leoxxx00/Solid-work-Lamp-design/Final/anglepoise bulk costs for a single lamp (1).xlsx

Sheet: Sheet1
Name | Decription | Source Reference | QTY | BULK COST | Quantity used for a single lamp | Materials Cost for a single lamp
Materials for manufactured parts
Vacuum form plastic | 1.5 mm hips white plastic sheet 1220x915 | https://shop.stephen-webster.co.uk/product/high-impact-polystyrene-hips-gloss-matt-sheet/ | 1 | £14.46 | 20% | £2.08
alluminium | 10x10 channel 2m | https://www.aluminiumwarehouse.co.uk/10-mm-x-10-mm-x-2-mm-x-2-mm-aluminium-channel | 1 | £3.49 | 30% | £1.20
Postcrete | 20kg bag for base | https://www.wickes.co.uk/Blue-Circle-Ready-To-Use-Postcrete---20kg/p/221100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 | 1 | £4.75 | 1.50% | £0.12
Ultimaker build material | PLA filament 750g | https://3dgbire.com/collections/filaments/products/ultimaker-pla-white-filament?variant=27701729089 | 1 | £39.00 | 25% | £4.68
Stratysys Build material | ABS filament 983 cm3 | https://store.stratasys.com/stratasysstorefront/stratasys/en/Materials-%26-Service-Consumables/NA/Flavors/333-60302/p/333-60302 | 1 | £117.00 | 12% | £5.73
stainless steel rod | 5mm x 2m | https://www.metals4u.co.uk/materials/stainless-steel/stainless-steel-round/1674-p | 1 | £6.75 | 10% | £0.68
stainless steel rod | 3mm x 2m | https://www.metals4u.co.uk/materials/stainless-steel/stainless-steel-round/1659-p | 1 | £5.25 | 4.00% | £0.22
zinc plated threaded rod | M4 threaded rod 1m for base unit | https://www.orbitalfasteners.co.uk/products/m4-x-1m-mild-steel-studding-threaded-rod-grade-4-6-bright-zinc-plated-din-975 | 1 | £0.45 | 2.60% | £0.12
stainless threaded rod | M5 threaded rod 1m for connector | https://www.orbitalfasteners.co.uk/products/m5-x-1m-stainless-steel-studding-threaded-rod-a4-316-din-975 | 1 | £1.93 | 1.70% | £0.33
oak | 2mx620x40 wooden worktop for base unit | https://www.worktop-express.co.uk/wood_worktops/oak_worktops.html | 1 | £135.00 | 0.70% | £0.94
Plywood | 4mm Poplar Laser Plywood, 600mm x 300mm AB/AB | https://kitronik.co.uk/collections/plywood/products/3267-4mm-poplar-laser-plywood-600mm-x-300mm-abab | 1 | £2.82 | 20% | £0.56
Standard Parts
pins 30mm | 1 bag of 30 pins for spring support | https://www.amazon.co.uk/gp/product/B07G11FRXH/ref=ppx_yo_dt_b_asin_title_o01_s00?ie=UTF8&psc=1 | 30 | £7.99 | 4 Pins | £1.00
Elastic bands | 1kg bag 38x1.7 | https://www.amazon.co.uk/gp/product/B01N060OHF/ref=ppx_yo_dt_b_asin_title_o08_s00?ie=UTF8&psc=1 | 1 | £12.90 | 20 bands | £0.09
M5 threaded inserts | 50 M5x9.5 for plastic connector and wood base unit | https://www.amazon.co.uk/gp/product/B07YSVXWS8/ref=ppx_yo_dt_b_asin_title_o01_s01?ie=UTF8&psc=1 | 50 | £11.15 | 4 (QTY) | £1.84
M8 Threaded insert | 15 M8 threaded inserts for wooden base unit | https://www.amazon.co.uk/gp/product/B074J82JF7/ref=ppx_yo_dt_b_asin_title_o01_s00?ie=UTF8&psc=1 | 15 | £8.99 | 1 (QTY) | £0.60
knurled thumb screws | 10 Thumb screws for connector tightening | https://www.amazon.co.uk/gp/product/B07LFRB5VZ/ref=ppx_yo_dt_b_asin_title_o00_s00?ie=UTF8&psc=1 | 10 | £5.49 | 2 (QTY) | £1.10
nylon washers | M5 10mm 1mm thick | https://www.orbitalfasteners.co.uk/products/m5-nylon-66-washers-white-din-125-1a | 100 | £1.35 | 40 (QTY) | £0.03
M8 Allen bolt | 20 M8 allen bolt base attachment | https://www.amazon.co.uk/gp/product/B079611XWN/ref=ppx_yo_dt_b_asin_title_o00_s00?ie=UTF8&psc=1 | 20 | £6.89 | 3 (QTY) | £1.03
M8 Washer | M8 washer for base attachment | https://www.screwfix.com/p/easyfix-a2-stainless-steel-flat-washers-m8-x-1-6mm-100-pack/8339t | 100 | £2.79 | 1 (QTY) | £0.28
M5 Washer | M5 washer | https://www.accu.co.uk/flat-washers/465683-HPW-4-3-9-0-8-N?uk_google_shopping=1&c=3 (https://www.amazon.co.uk/10mm-Allen-Socket-Head-Screws/dp/B08GY8PCTN) | 50 | £4.45 | 2 | £17.80
M5 allen bolt | M5 22mm allen bolt | https://www.screwfix.com/p/easyfix-button-head-socket-screws-a2-stainless-steel-m5-x-16mm-50-pack/8345t | 50 | £3.09 | 4 (QTY) | £0.25
M3 allen bolt | M3 (3mm x 10mm) Allen Socket Cap Head Screws | https://www.amazon.co.uk/10mm-Allen-Socket-Head-Screws/dp/B08GY8PCTN | 20 | £4.99 | 2 | £0.50
lamp holder | Baynonet fixing lamp holder | https://www.electricalcounter.co.uk/products/Wiring+Accessories/Ceiling+Accessories/T2+BC+Cord+Grip+Lampholder+IP20+100W+230V/1937848833 | 1 | £0.84 | 1 (QTY) | £0.84
cable | 50m 2 core cable | https://www.screwfix.com/p/time-2192y-white-2-core-0-75mm-flexible-cable-50m-drum/49458 | 1 | £9.99 | 2.70% | £0.27
Plug | 3 pin plug | https://www.screwfix.com/p/diall-13a-fused-plug-white/5751h | 10 | £7.90 | 1 (QTY) | £0.86
fuse | 3amp fuse pack of 10 | https://www.amazon.co.uk/gp/product/B07FVT444P/ref=ppx_yo_dt_b_asin_title_o00_s00?ie=UTF8&psc=1 | 10 | £1.90 | 1 (QTY) | £0.19
M8 screw head | M8-1.25 Hex Nuts, Stainless Steel 304(A2) Hex Nut, Bright Finish | https://www.amazon.co.uk/M8-1-25-Stainless-Bright-Finish-Quantity/dp/B094Z6VZ9X?sp_csd=d2lkZ2V0TmFtZT1zcF9hdGY | 20 | £6.49 | 2 (QTY) | £0.65
Consumables
super glue | 50g - for 25mm pin attachment | https://www.screwfix.com/p/no-nonsense-superglue-50g/79181 | 1 | £1.99 | 10G | £0.40
thread lock | 50ml - for allen bolts in threaded inserts | https://www.amazon.co.uk/gp/product/B01IEIZCX4/ref=ppx_yo_dt_b_asin_title_o00_s00?ie=UTF8&psc=1 | 1 | £8.50 | 5ml | £0.85
PVA glue | 5 litres PVA for sealing concrete | https://www.screwfix.com/p/no-nonsense-pva-5ltr/57248 | 1 | £9.99 | 10ml | £0.20
Alumium soldering rod | DURAFIX® - 20 Aluminum Welding rods | https://www.amazon.co.uk/gp/product/B00RD9CFX6/ref=ox_sc_saved_title_2?smid=AN4YM79HKEWTY&psc=1 | 1 | £34.37 | 4g | £0.60
 |  |  |  | £482.95 |  | £46.04
Cost of Assembly
One person | A person with one hour per 15 pounds rate |  |  |  |  | £15.00
 | (Estimated assembly time is one lamp per an hour) |  |  |  | Total cost per Lamp | £61.04

Sheet: Sheet2
electronics advanced
PCB + LED |  | https://www.kitronik.co.uk/2169-round-5v-led-matrix-lamp.html | 1 | £2.34
in-line switch | what core cable what amp req | https://www.amazon.co.uk/in-LINE-Switch-2A-White/dp/B007K7TA66 | 1 | £1.75
stand off mounts |  | https://www.ukpos.com/acrylic-sign-standoffs-hole-mount?vat=2 | 2 | £2.00
