leoxxx00/Solid-work-Lamp-design/ASSEMBLY/Assembly instructions steps solid files/step 13.SLDASM

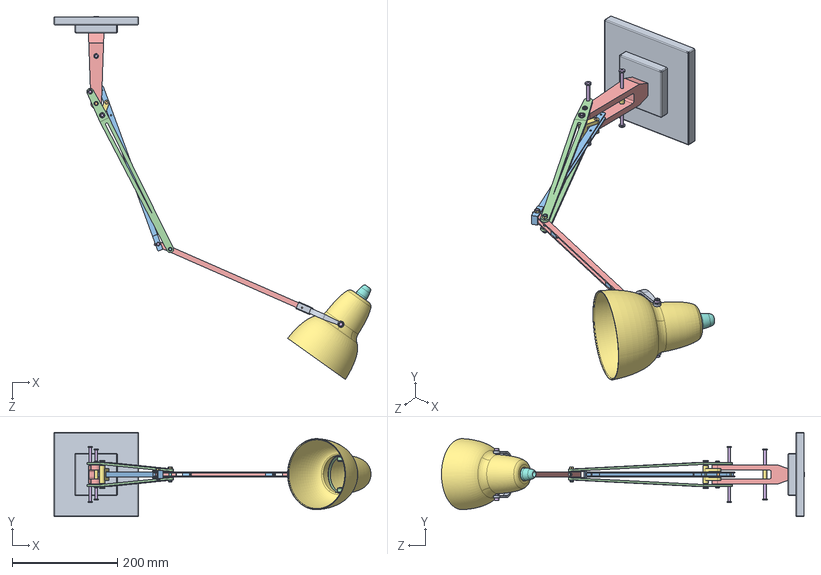
[picture p3: CAD file, 2024-01-07]
ASSEMBLY/Assembly instructions steps solid files/step 13.SLDASM
601.1 x 160.0 x 688.3 mm
Angle pose base plane 1
M8 base screw 2
M8 base washer 3
base threaded insearts 4
lamp base 5
biding pin 6 x 4
tube (M3 threaded bar holder) 8
M3 threded bar 7
threaded insert for lamp nase uppper screws 9 x 2
m5 14.5mm screw x 2
washer for upper screws of lamp base 10 x 2
outer wodden arms 11 x 2
screw 3mm into biding pin of outer arms 12 x 2
threaded bar M5 54mm 13
Angle poise connector 15
washer for M5 threaded bar 16 x 2
Thumb screw M5 17 x 2
threaded bar M5 22mm 14
1st tyer inner metal arm 18
3mm x 10 mm rod 19 x 2
2nd tyer inner arm 20
M8 Allen bolt short 22
M8 Allen bolt head 23 x 2
M8 Allen bolt long 21
Angle poise Yoke 25
3mm yoke refill cylinder rod 24
wire holder 31 x 4
Angle poise lampshade Reinforcement 28
reinforcement m5 threaded insearts 29 x 2
York M5 screw 26 x 2
Anglepoise lamphead 27
light fitting 30
