leoxxx00/Solid-work-Lamp-design/ASSEMBLY/Assembly instructions steps solid files/step 2.SLDASM

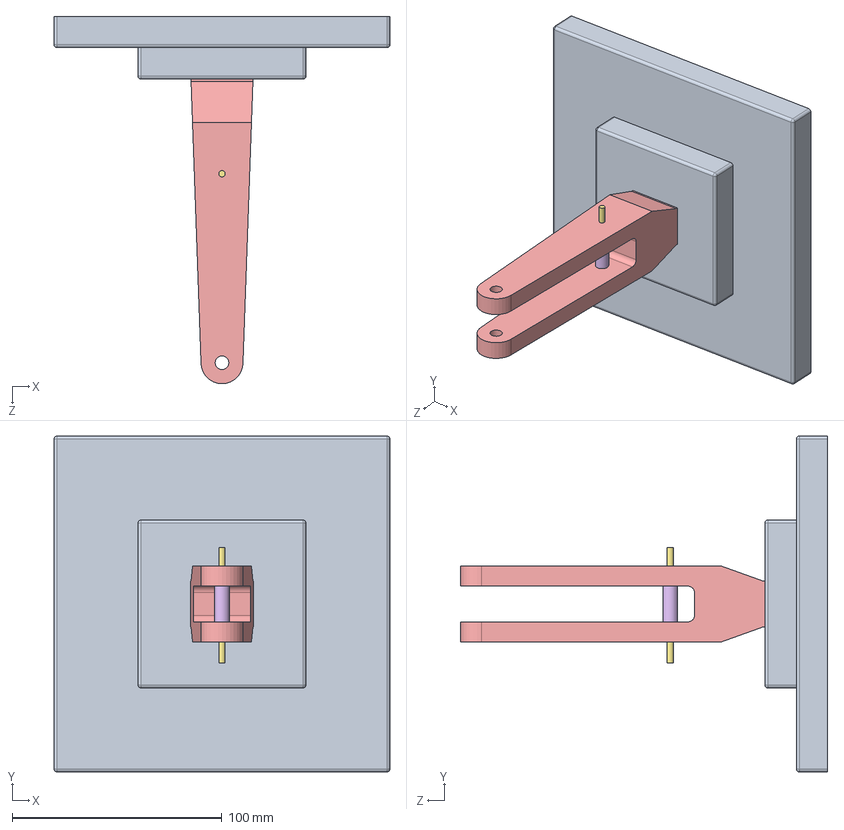
[picture p4: CAD file, 2024-01-07]
ASSEMBLY/Assembly instructions steps solid files/step 2.SLDASM
160.0 x 160.0 x 175.0 mm
Angle pose base plane 1
M8 base screw 2
M8 base washer 3
base threaded insearts 4
lamp base 5
tube (M3 threaded bar holder) 8
M3 threded bar 7
