leoxxx00/Solid-work-Lamp-design/ASSEMBLY/Assembly instructions steps solid files/step 1.SLDASM

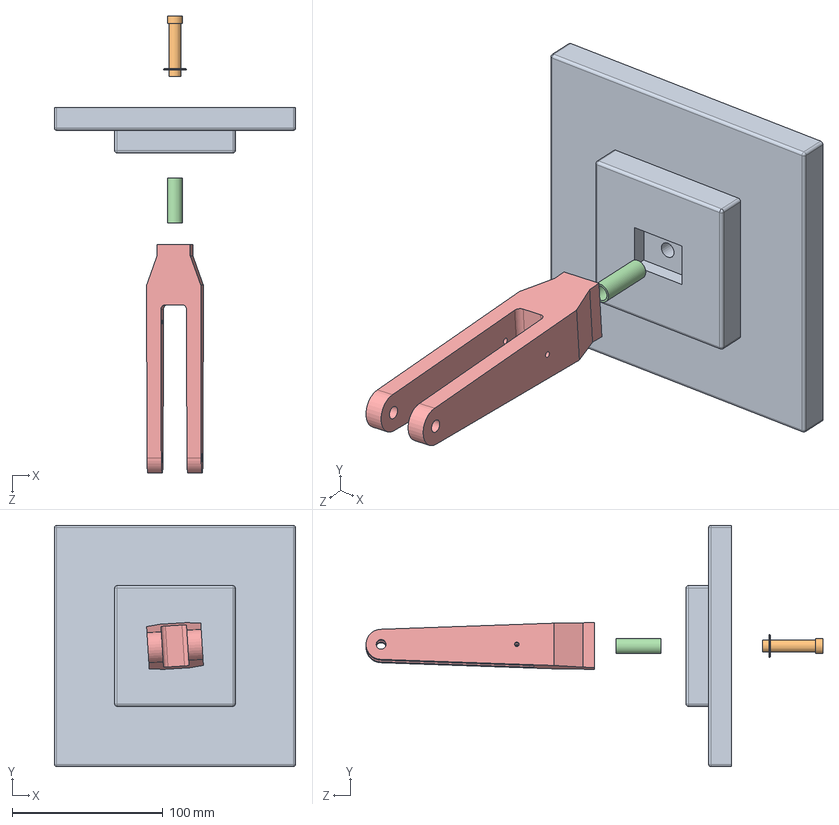
[picture p5: CAD file, 2024-01-07]
ASSEMBLY/Assembly instructions steps solid files/step 1.SLDASM
160.0 x 160.0 x 302.9 mm
Angle pose base plane 1
M8 base screw 2
M8 base washer 3
base threaded insearts 4
lamp base 5
