leoxxx00/Solid-work-Lamp-design/ASSEMBLY/Assembly instructions steps solid files/step 4.SLDASM

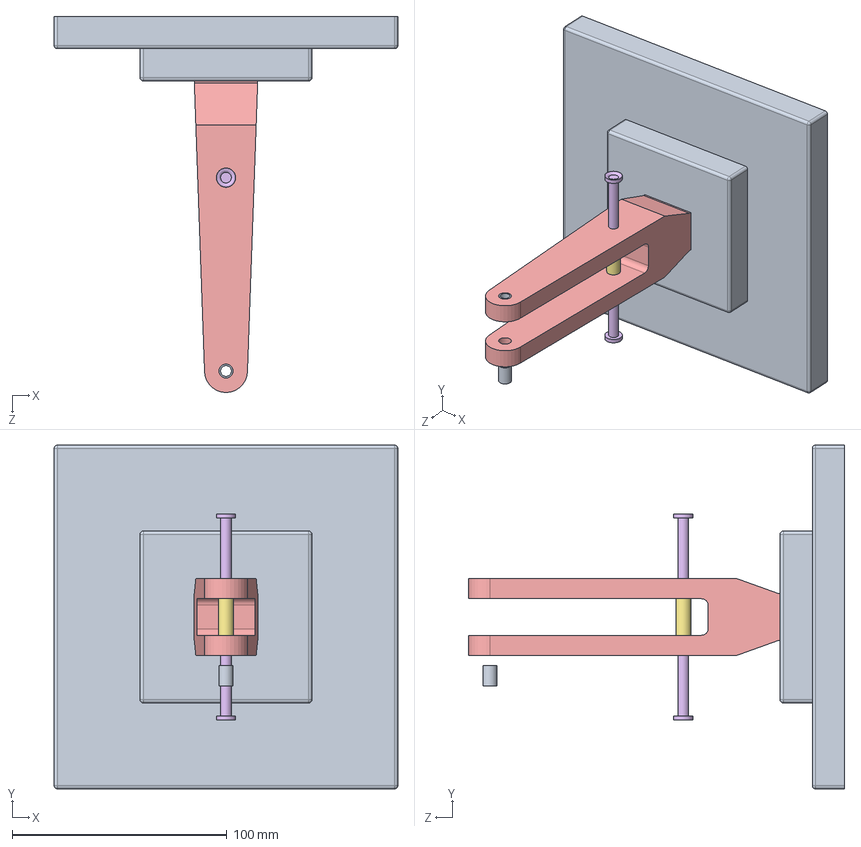
[picture p9: CAD file, 2024-01-07]
ASSEMBLY/Assembly instructions steps solid files/step 4.SLDASM
160.0 x 160.0 x 175.0 mm
Angle pose base plane 1
M8 base screw 2
M8 base washer 3
base threaded insearts 4
lamp base 5
biding pin 6 x 2
tube (M3 threaded bar holder) 8
M3 threded bar 7
threaded insert for lamp nase uppper screws 9 x 2
