leoxxx00/Solid-work-Lamp-design/PARTS/tube (M3 threaded bar holder) 8.SLDPRT

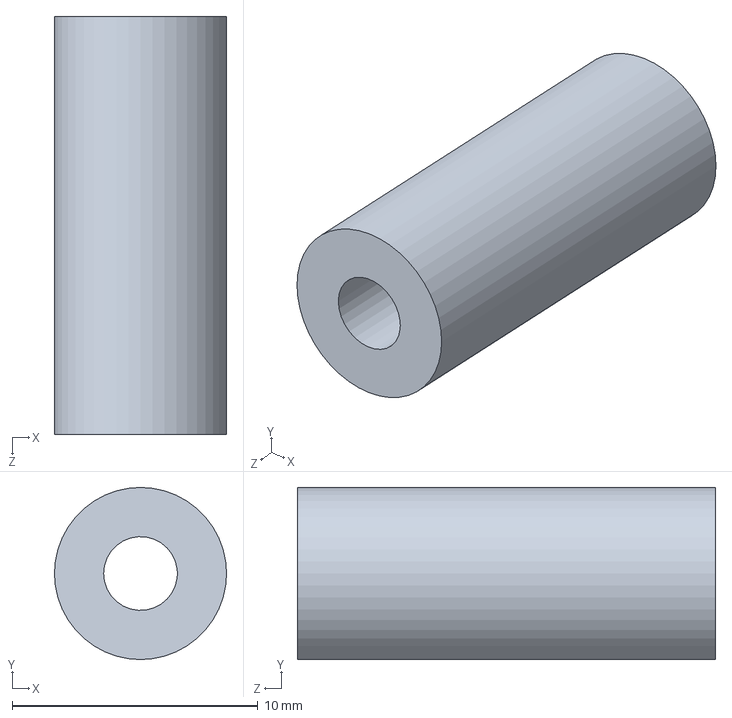
[picture p18: CAD file, 2024-01-07]
PARTS/tube (M3 threaded bar holder) 8.SLDPRT
7.00 x 7.00 x 17.0 mm
