leoxxx00/Solid-work-Lamp-design/PARTS/Angle poise lampshade Reinforcement 28.SLDPRT

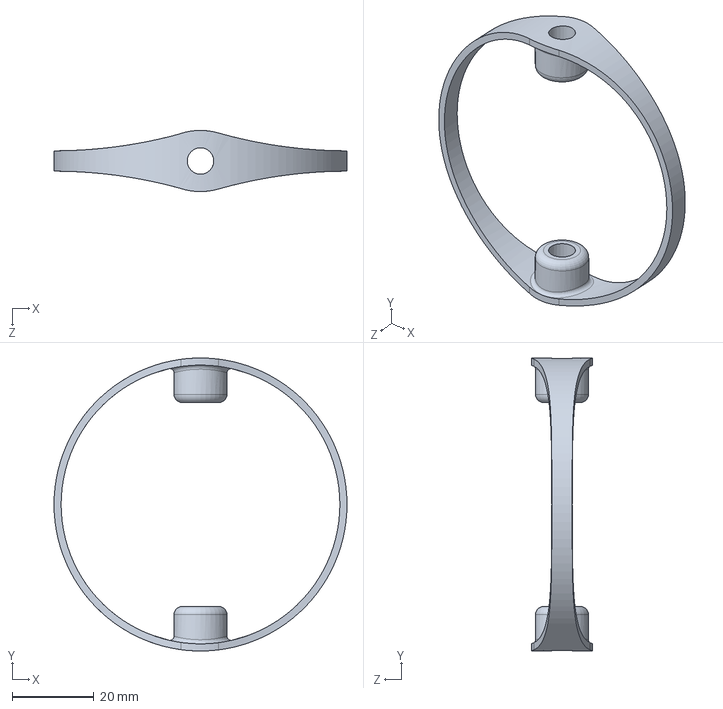
[picture p19: CAD file, 2024-01-07]
PARTS/Angle poise lampshade Reinforcement 28.SLDPRT
71.8 x 71.8 x 15.0 mm
