leoxxx00/Solid-work-Lamp-design/PARTS/threaded bar M5 54mm 13.SLDPRT

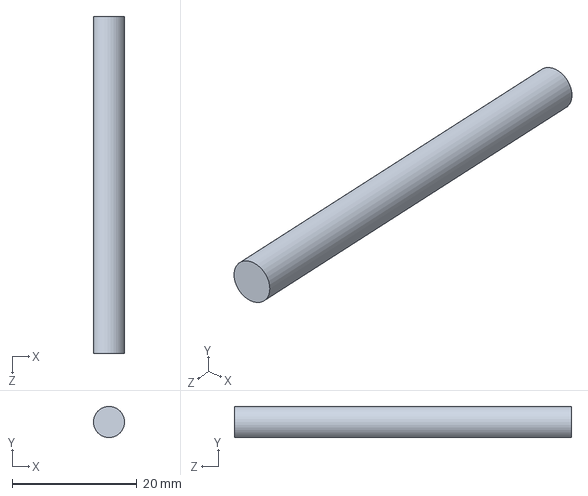
[picture p20: CAD file, 2024-01-07]
PARTS/threaded bar M5 54mm 13.SLDPRT
5.00 x 4.98 x 54.0 mm
