leoxxx00/Solid-work-Lamp-design/PARTS/Angle poise Yoke 25.SLDPRT

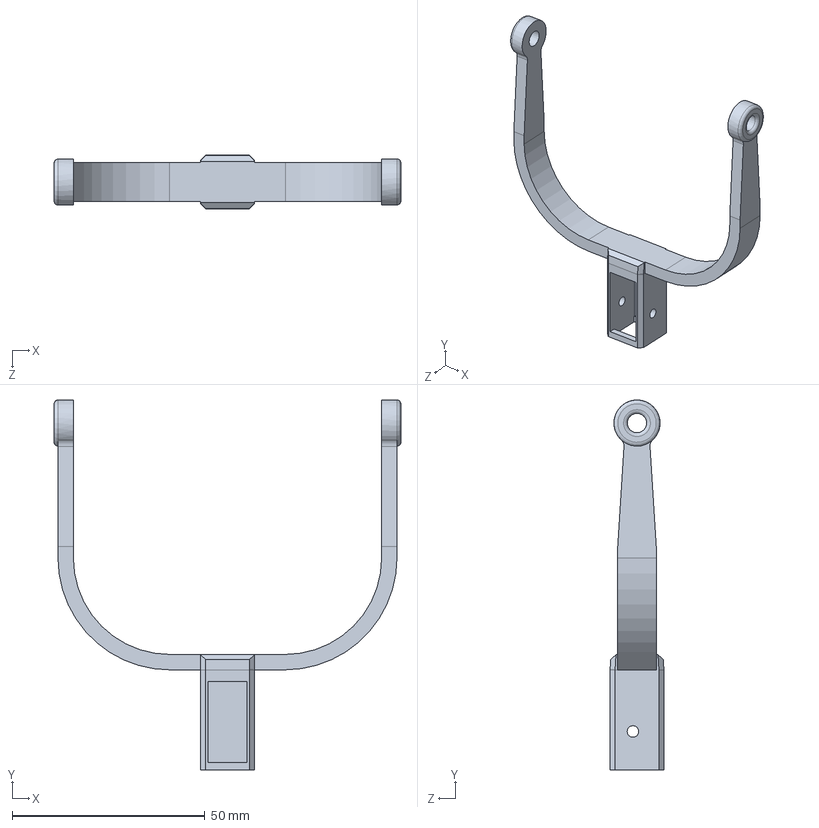
[picture p21: CAD file, 2024-01-07]
PARTS/Angle poise Yoke 25.SLDPRT
90.0 x 96.0 x 14.0 mm
