leoxxx00/Solid-work-Lamp-design/PARTS/1st tyer inner metal arm  18.SLDPRT

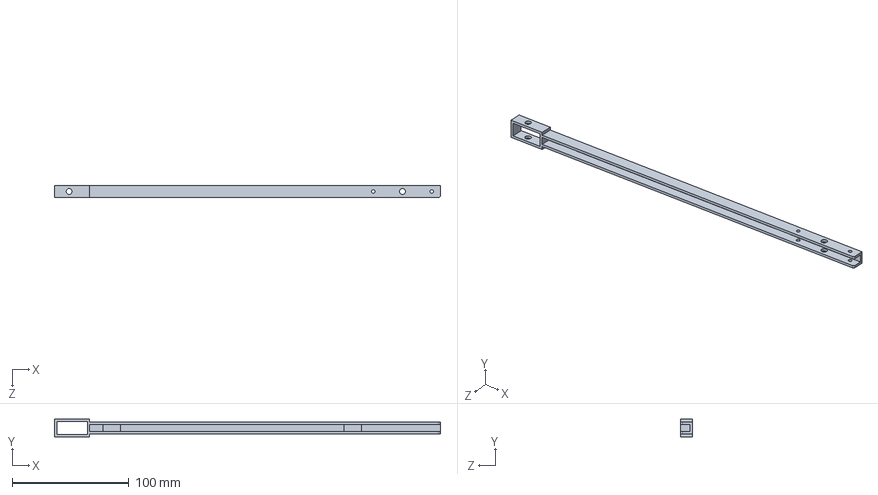
[picture p22: CAD file, 2024-01-07]
PARTS/1st tyer inner metal arm 18.SLDPRT
330.0 x 15.0 x 10.0 mm
