leoxxx00/Solid-work-Lamp-design/PARTS/2nd tyer inner arm 20.SLDPRT

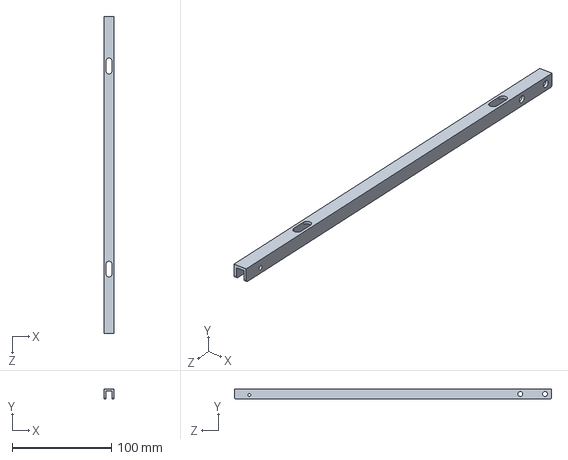
[picture p23: CAD file, 2024-01-07]
PARTS/2nd tyer inner arm 20.SLDPRT
10.0 x 10.0 x 320.0 mm
