leoxxx00/Solid-work-Lamp-design/PARTS/light fitting 30.SLDPRT

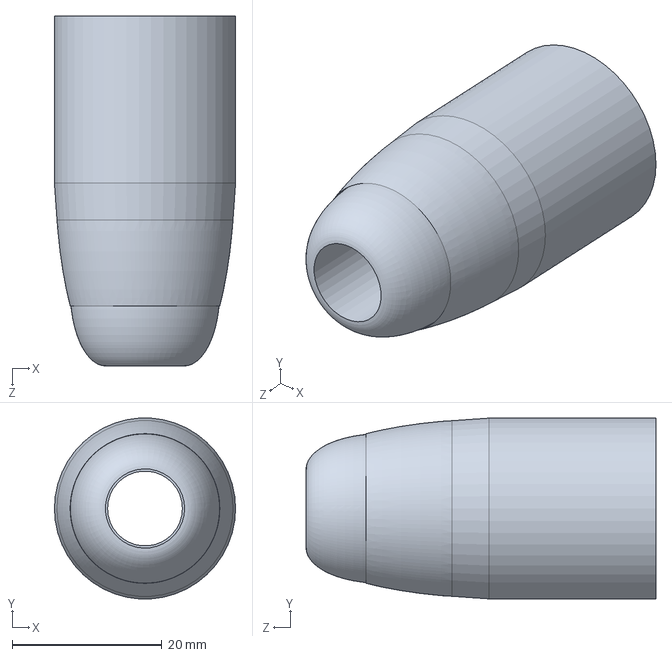
[picture p24: CAD file, 2024-01-07]
PARTS/light fitting 30.SLDPRT
24.2 x 24.2 x 46.8 mm
