leoxxx00/Solid-work-Lamp-design/PARTS/3mm x 10 mm rod  19.SLDPRT

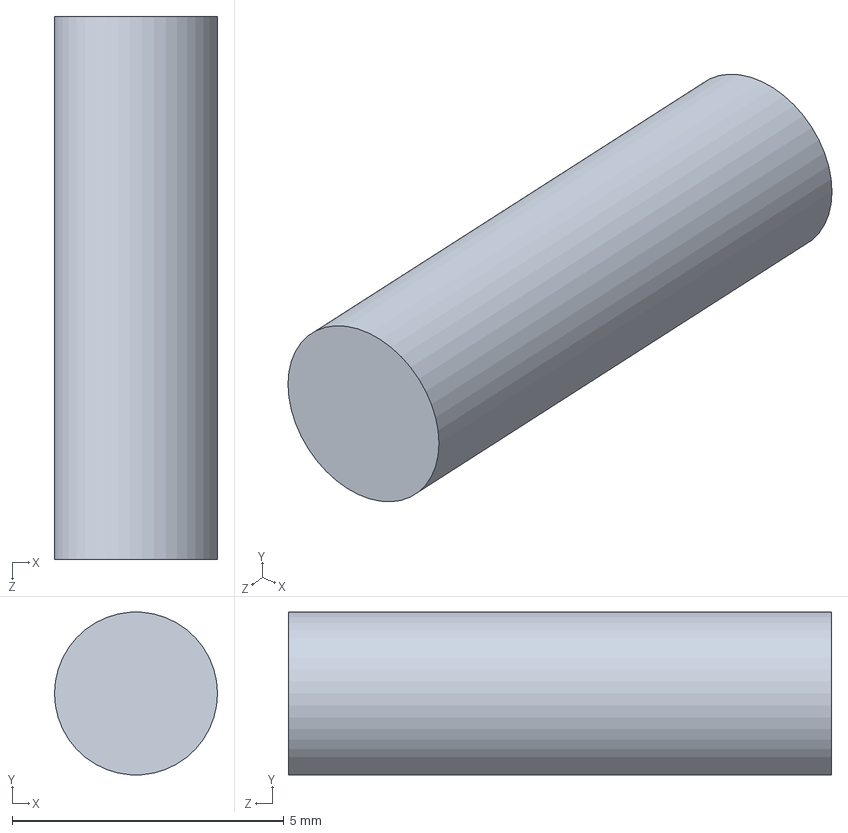
[picture p25: CAD file, 2024-01-07]
PARTS/3mm x 10 mm rod 19.SLDPRT
3.00 x 2.99 x 10.0 mm
