leoxxx00/Solid-work-Lamp-design/PARTS/lamp base 5.SLDPRT

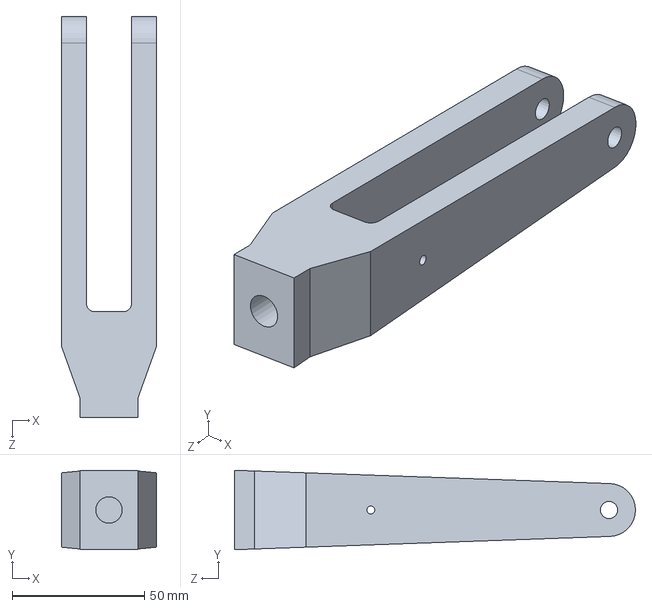
[picture p26: CAD file, 2024-01-07]
PARTS/lamp base 5.SLDPRT
36.0 x 30.0 x 151.5 mm
