leoxxx00/Solid-work-Lamp-design/PARTS/biding pin 6.SLDPRT

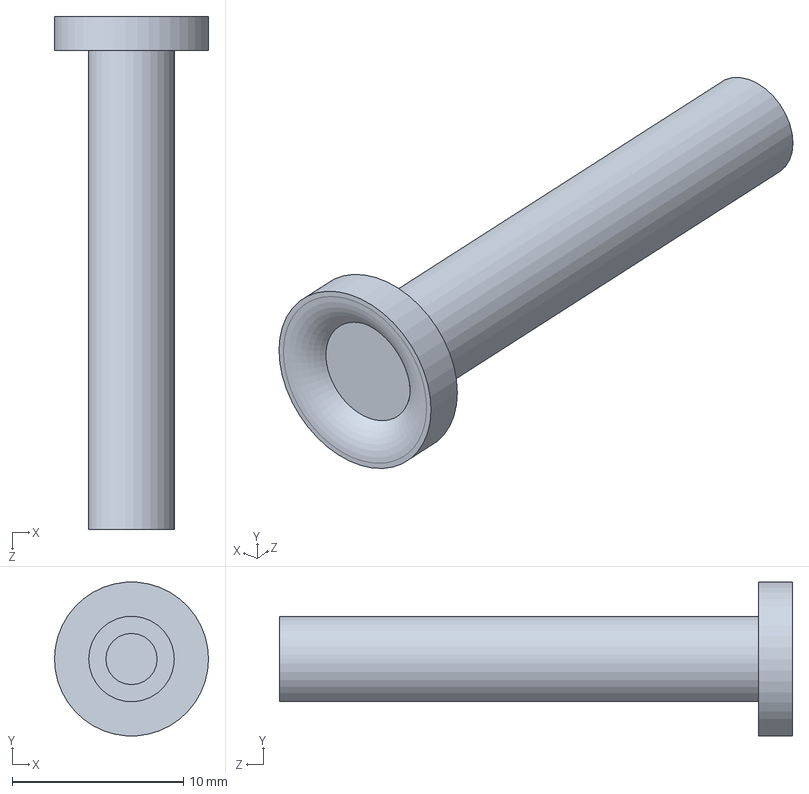
[picture p27: CAD file, 2024-01-07]
PARTS/biding pin 6.SLDPRT
9.00 x 8.97 x 30.0 mm
