leoxxx00/Solid-work-Lamp-design/PARTS/threaded bar M5 22mm 14.SLDPRT

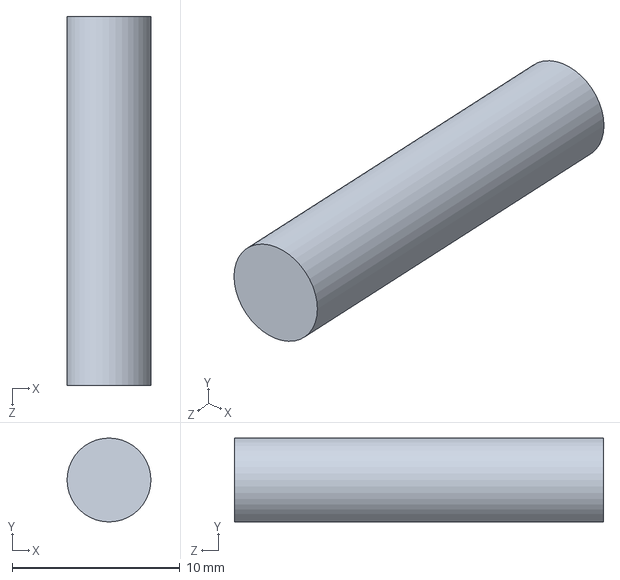
[picture p28: CAD file, 2024-01-07]
PARTS/threaded bar M5 22mm 14.SLDPRT
5.00 x 5.00 x 22.0 mm
