leoxxx00/Solid-work-Lamp-design/PARTS/base threaded insearts 4.SLDPRT

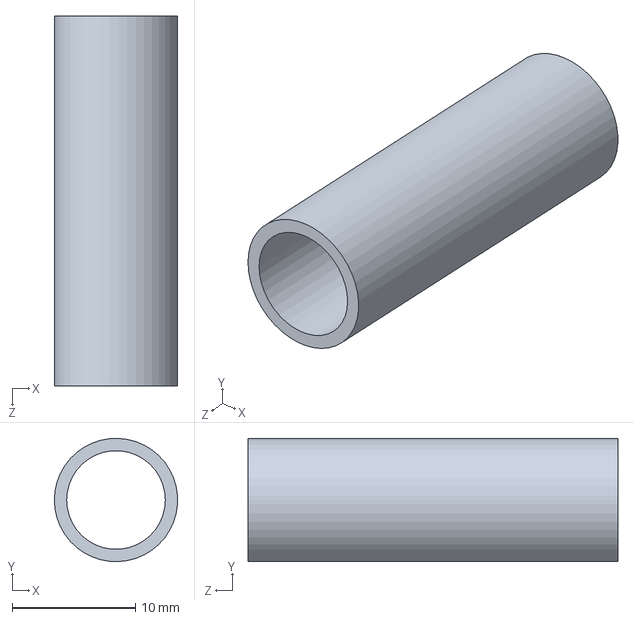
[picture p29: CAD file, 2024-01-07]
PARTS/base threaded insearts 4.SLDPRT
10.0 x 9.99 x 30.0 mm
