leoxxx00/Solid-work-Lamp-design/PARTS/wire holder 31.SLDPRT

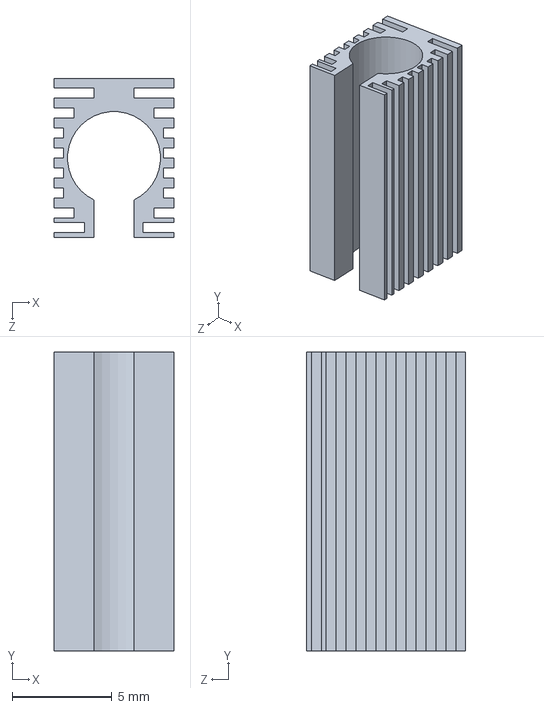
[picture p30: CAD file, 2024-01-07]
PARTS/wire holder 31.SLDPRT
6.00 x 15.0 x 8.00 mm
