leoxxx00/Solid-work-Lamp-design/PARTS/3mm yoke refill cylinder rod 24.SLDPRT

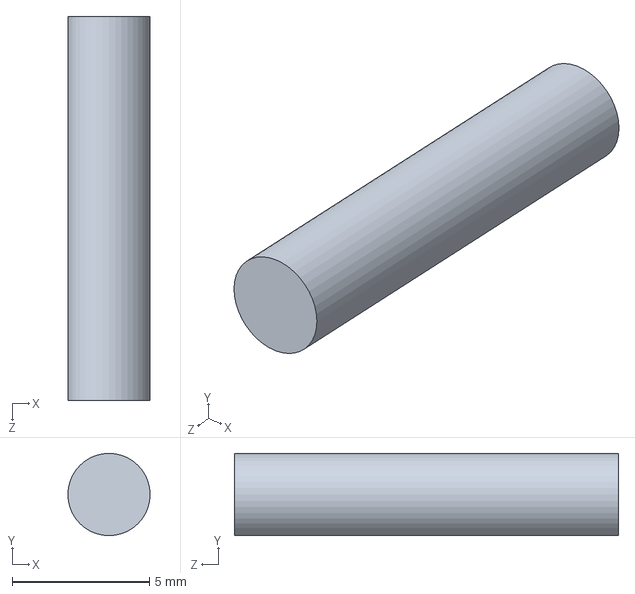
[picture p31: CAD file, 2024-01-07]
PARTS/3mm yoke refill cylinder rod 24.SLDPRT
3.00 x 3.00 x 14.0 mm
