leoxxx00/Solid-work-Lamp-design/PARTS/reinforcement m5 threaded insearts 29.SLDPRT

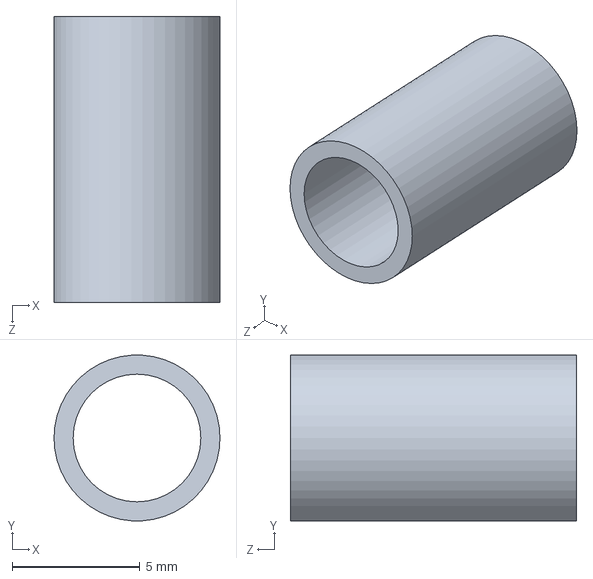
[picture p32: CAD file, 2024-01-07]
PARTS/reinforcement m5 threaded insearts 29.SLDPRT
6.50 x 6.48 x 11.2 mm
