leoxxx00/Solid-work-Lamp-design/PARTS/Angle pose base plane 1.SLDPRT

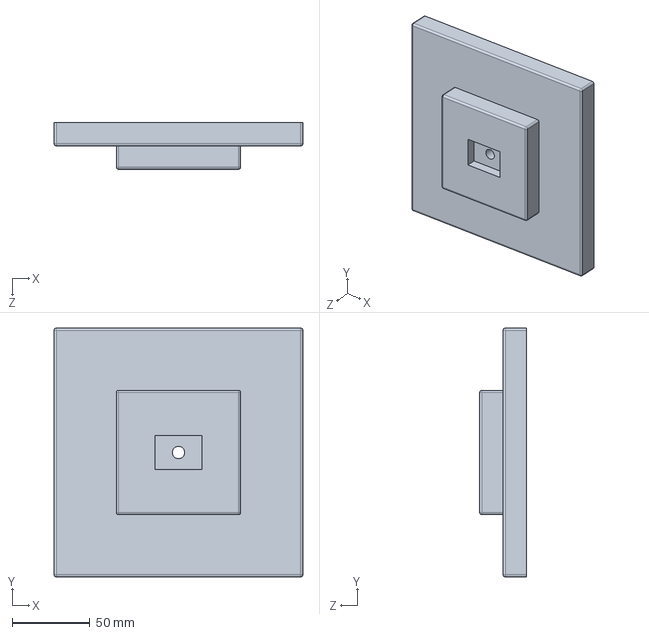
[picture p33: CAD file, 2024-01-07]
PARTS/Angle pose base plane 1.SLDPRT
160.0 x 160.0 x 30.0 mm
