leoxxx00/Solid-work-Lamp-design/PARTS/Anglepoise lamphead 27.SLDPRT

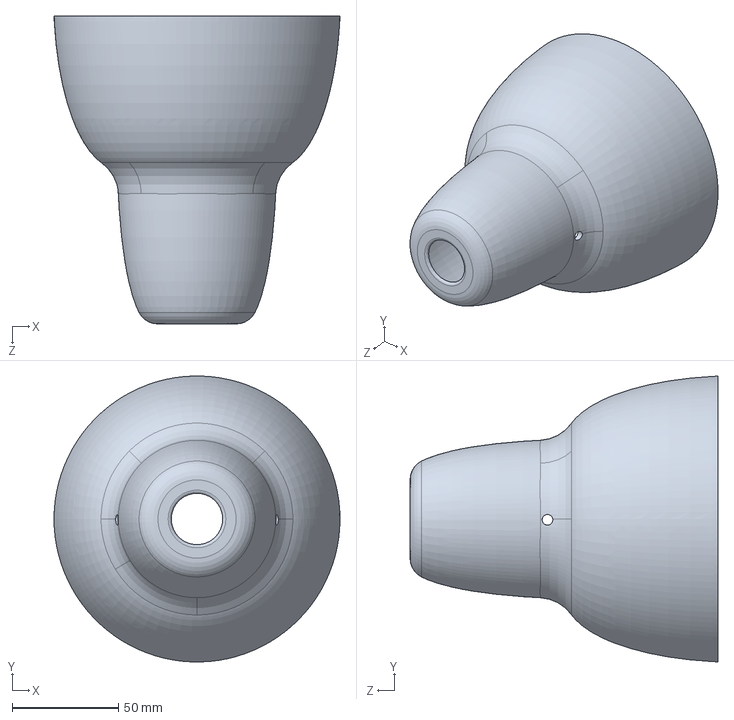
[picture p34: CAD file, 2024-01-07]
PARTS/Anglepoise lamphead 27.SLDPRT
134.7 x 134.6 x 145.0 mm
