leoxxx00/Solid-work-Lamp-design/PARTS/Angle poise connector 15.SLDPRT

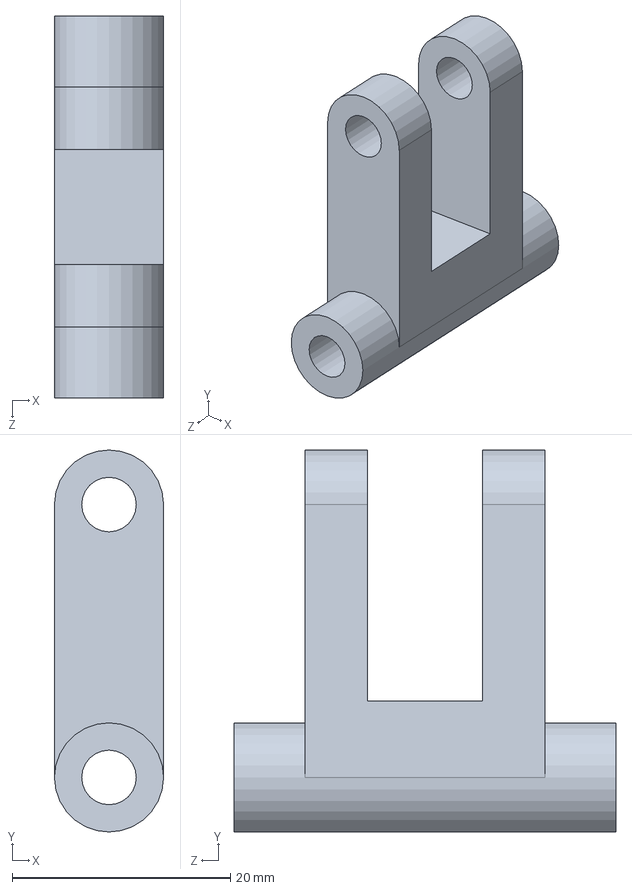
[picture p35: CAD file, 2024-01-07]
PARTS/Angle poise connector 15.SLDPRT
10.0 x 35.0 x 35.0 mm
