leoxxx00/Solid-work-Lamp-design/PARTS/M3 threded bar 7.SLDPRT

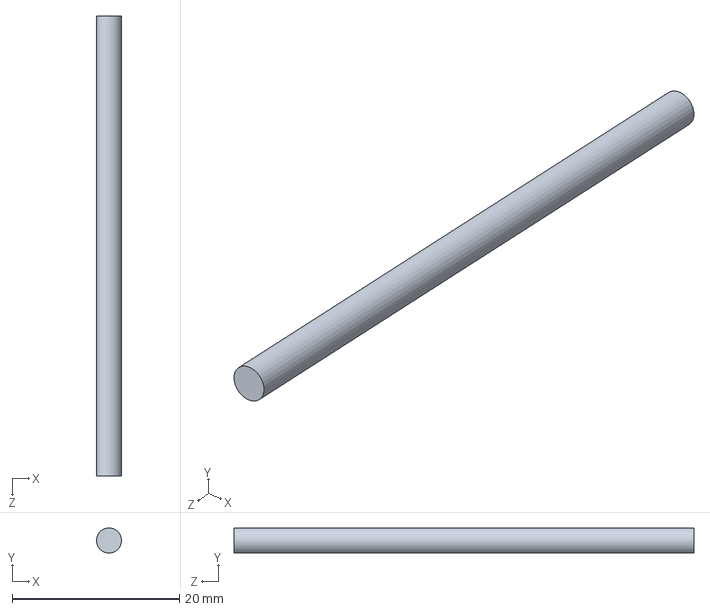
[picture p36: CAD file, 2024-01-07]
PARTS/M3 threded bar 7.SLDPRT
3.00 x 2.98 x 55.0 mm
