leoxxx00/Solid-work-Lamp-design/PARTS/outer wodden arms 11.SLDPRT

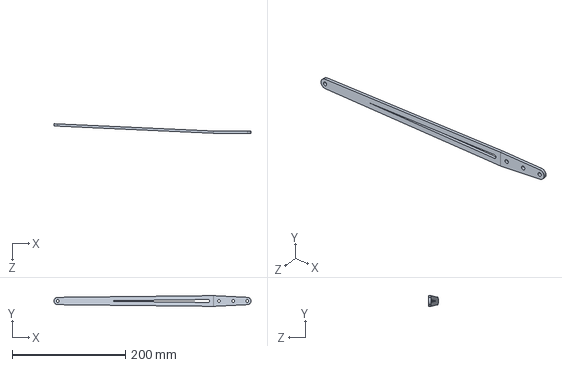
[picture p37: CAD file, 2024-01-07]
PARTS/outer wodden arms 11.SLDPRT
347.9 x 19.0 x 16.9 mm
