leoxxx00/Solid-work-Lamp-design/(list of files, cad)

Other CAD files:
Final/General Assembly drawing.SLDDRW
PARTS/M5 yolk screw head 27.SLDPRT
PARTS/M8 Allen bolt head 23.SLDPRT
PARTS/M8 Allen bolt long 21.SLDPRT
PARTS/M8 Allen bolt short 22.SLDPRT
PARTS/M8 base screw 2.SLDPRT
PARTS/M8 base washer 3.SLDPRT
PARTS/Thumb screw M5 17.SLDPRT
PARTS/York M5 screw 26.SLDPRT
PARTS/m5 14.5mm screw.SLDPRT
PARTS/m5 14.5mm.SLDPRT
PARTS/screw 3mm into biding pin of outer arms 12.SLDPRT
PARTS/screw to connect upper side oh Y wood to arms.SLDPRT
PARTS/threaded insert for lamp nase uppper screws 9.SLDPRT
PARTS/washer for M5 threaded bar 16.SLDPRT
PARTS/washer for upper screws of lamp base 10.SLDPRT
